diynotaguy/3D-printed-tape-dispenser-with-mechanical-tape-length-measuring/README.md

# 3D-printed-tape-dispenser-with-mechanical-tape-length-measuring
A 3D printed tape dispenser that shows you how long a piece of tape you're pulling out is before you cut it. Works best for washi tape or paper-like tape, because the tape cutter is 3D printed and not very sharp

front on pic
screen Vs irl comparison


# Why I made this
I made the project because I wanted a tape dispenser that would fit in my drawer (its quite a tall/deep drawer) and be usable without taking it out. That's why I designed it so that you pull and cut the tape from above. As for the measuring part, I just thought it might be useful, I'd never seen a tape dispenser measure the tape before, and it seemed challenging and fun to make (which I can confirm is true!!). 

In the future, I'd like to make the measuring more accurate, add a mechanism that automatically resets the measuring cylinder to 0 when the tape is cut, and also make it compatible with gridfinity. 

# You will need
- 3D printer filament (PLA or other rigid filament)
- A 8x22x7mm ball bearing (you might be able to 3D print one from someone else's file)
  
*more details in BOM*

# Printing instructions
The best way is to slice the 'Ship 1 both plates slicer file.3mf' file in Bambu studio, as it should import with the required printing settings. Otherwise, follow the instructions below.

## Orientation
- All parts are oriented correctly in the .3mf file
- If using inividual .step files, automatic orientation works for all pieces - none of them need unusual orientations

## Supports
Only around 3.5g of support is needed, so if you follow these instructions, you should get a similar result:
- turn on tree supports for the bearing casing and tray parts
- turn on normal supports for the bearing holder part

## Brims (in the pictures, the brim is dark blue)
- add brim ears at each corner of the tape cutter part like so 


- add an outer brim to the driven axle/secondary axle part
- add brim ears on either end of the chain like so


- if any other parts are causing warping or adhesion issues, add an outer brim

## Main settings/instructions
- PLA or any other rigid filament can be used
- 0.2mm layer height is suitable
- 2 wall loops, 15% infill is suitable

# Assembly instructions
For simplicity, the assembly instructions are broken up into 6 sections:
1) The chain
2) The driven axle/secondary axle
3) The driving axle/primary axle
4) The tape recovery system
5) Attaching the axles
6) Finishing the tape dispenser

I've arranged the parts on the second build plate in groups so that it's easier to tell which pieces you need to use for which step:



Key:
Purple = driven axle parts
Green = driving axle parts
Red = tape recovery system parts

## 1) The chain
1. Rotate each link in the chain so that it can articulate. You'll probably need pliers to free the two end links, but be careful not to crush them when gripping them with the pliers.
   
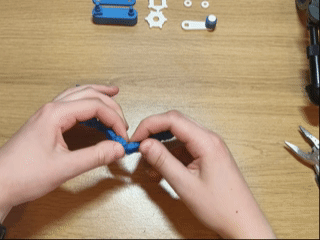
[picture p1: Side project - chain & sprocket mechanism/side project gifs/C&S mech assembly pt1.gif]


2. Rotate the chain into a loop so that the side on the build plate is on the outside. Use a dab of superglue on the dovetail joint where the chain needs join and push the dovetail pin into the socket. I'd recommend using a cocktail stick or something similar to apply the glue to avoid gluing your fingers or jamming the chain.
   
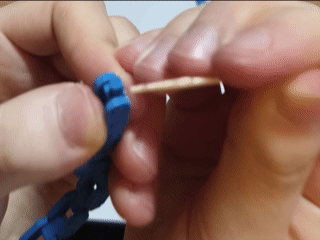
[picture p2: Side project - chain & sprocket mechanism/side project gifs/C&S mech assembly pt2.gif]


## 2) The driven axle
1. Slide the driven gear then the axle spacer on the driven axle. The chamfered end of the axle spacer should be towards the driven gear



2. Slide the number cylinder on the axle, with the numbers going upwards in the clockwise direction when the back of the axle (where the driven gear is) is pointing away from you.


3. Put the axle holder on the axle, with the screw pointing away from the number cylinder


## 3) The driving axle
1. Put the bearing on the bearing holder and screw the bearing holder nut on



2. Push the bearing casing over the bearing


3. Align the square recess in the driving gear with the end of the bearing casing, and screw the driving gear screw through the driving gear and into the bearing casing



4. Your completed driving axle should look like this:


## 4) The tape recovery system
1. Place the push piece in the channel on the tape cutter with the dovetail section poking through the hole


2. Slot the slider onto the end of the push piece dovetail section from the other side of the tape cutter, then slide then push the sider and push piece in opposite directions so they become locked together.



## 5) Attaching the axles
1. Put the chain around the driven gear, then slot the driven axle assembly into the tray on the right hand side. The driven gear & chain need to be at the back, and the screw on the driven axle holder needs to be slotted into the channel on the front right hand side of the tray.



2. Screw the driven axle holder nut onto the screw of the axle holder to secure the driven axle in place


3. Mesh the driving gear on the driving axle assembly with the inside of the chain, then slot the bearing holder into the bearing holder pocket which is on the front left hand side of the tray. The driving axle should also now be secure, and you should be able to rotate the bearing casing or the end of the driven axle to move the chain and therefore move the other axle.



## 6) Finishing it! 
1. Line up the tape cutter (with the tape recovery system attached) with the brackets on the top of the tray, and slide it all the way in 



2. Put your tape roll of choice in the base of the tray with it already partially unrolled. Then push the tape holder part through the middle of your tape roll and into the tray, making sure the tray lines up with the tape holder at both the triangular joint at the back of the tray and the dovetail joint at the front.



3. At the top of the tray, slide your tape tail (the bit you've unrolled already) into its position. It needs to go over the bearing casing, under the tape recovery system, then come out of the tape dispenser by the serrated teeth of the tape cutter. Make sure that the tape tail is either temporarily stuck to a part of the tape cutter or sticking out long enough so that you don't lose it within the tape dispenser when performing the next assembly steps.


4. Line up the reinforcing cross-beam with the top of the whole assembly and push it in. To get it properly past the driven axle holder, you may need to pull the driven axle down while pushing the cross-beam in



5. The tape dispenser should look like this when finished! To make it ready for use, just cut the tape then follow the instructions in the next section
front on pic

# How to use
You can watch [this demo](https://youtube.com/shorts/kDhBerEQ1j0?feature=share) or follow the instructions below
1) Set the number cylinder to 0 by turning the end of the driven axle
2) Slide the slider on top of the tape cutter towards the serrated teeth of the tape cutter and then pick the end of the tape off from the end of the tape recovery push piece
3) Pull the tape. When pulling, you can watch the number on the number cylinder increase through the viewing hole on the top. The little arrow next to the viewing hole points to the current measurement, and the tape is measured in cm.
4) Cut the tape at the desired length by pulling it against the serrated teeth of the tape cutter. For best results, pull **diagonally** towards the back right of the tape dispenser, rather than straight towards the right.
5) If you completed the steps correctly, the cut piece of tape should be similar in length to the measurement given by the tape dispenser. It's not completely accurate though, so give or take a cm.
