diynotaguy/3D-printed-tape-dispenser-with-mechanical-tape-length-measuring/CAD/onshape source file.md

https://cad.onshape.com/documents/6b50cb8246abad94566a4989/w/5acfffb6b951ba959ce26331/e/a58cd0b4d890e8ca2b29ab2b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
