diynotaguy/3D-printed-tape-dispenser-with-mechanical-tape-length-measuring/Pictures/front on pic.jpg

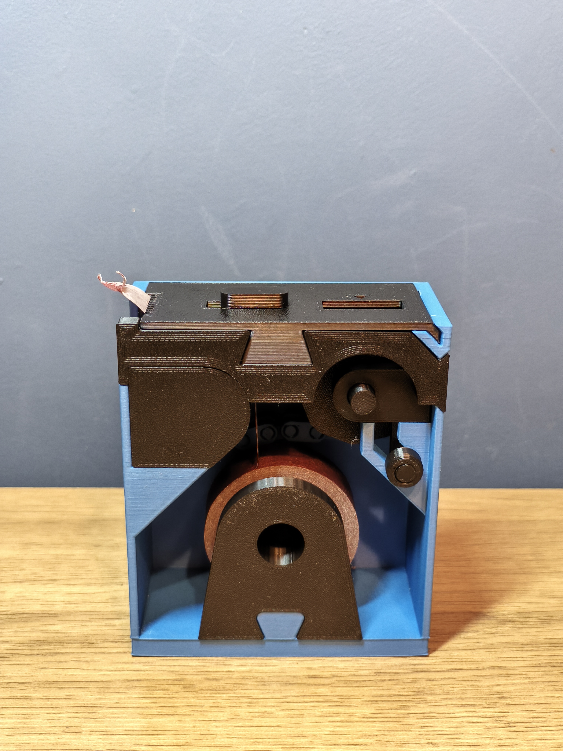
Pictures/front on pic.jpg
