diynotaguy/3D-printed-tape-dispenser-with-mechanical-tape-length-measuring/Side project - chain & sprocket mechanism/side project gifs/Rotating chain landscape gif.gif

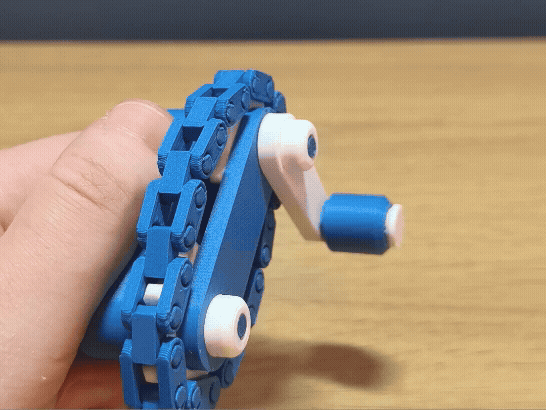
Side project - chain & sprocket mechanism/side project gifs/Rotating chain landscape gif.gif
