diynotaguy/3D-printed-tape-dispenser-with-mechanical-tape-length-measuring/Tape dispenser Ship 1 BOM.csv

Item Name | Qty | Price (total) (USD) | Item link | Notes
102g 3D printer filament (PLA) | 1 | $15.29 | https://us.amazon.com/SUNLU-Printer-Filament-Dimensional-Accuracy/dp/B07ZNHF46J | Based on the price of a 1kg SUNLU PLA spool (which at time of writing is 5% off). The price is for the whole kg but you will only need 102g for the tape dispenser. This is a cheaper alternative to what I used, but you can use any type of standard PLA (or other similar rigid filaments)
22 (OD) * 8 (ID) * 7 mm ball bearing | 1 | $5.99 | https://www.amazon.com/Mlxkell-608-2RS-8mmx-7mmBall-Bearings/dp/B0F2FKKG9K?sp_csd=d2lkZ2V0TmFtZT1zcF9hdGY | Only ONE ball bearing needed - this is the price for the whole pack. This isn't the specific one I used, because I found the one I used just lying around in a hardware box but I measured it and these are the same size.
Shipping for filament & bearings | 1 |  |  | No cost - free delivery from Amazon in the UK
Final notes
Total Price (USD): | $21.28 |  |  | I do not need funding as I've already made it and it is very cheap to make (especially for people who already have filament and some ball bearings lying around)
