diynotaguy/3D-printed-tape-dispenser-with-mechanical-tape-length-measuring/Tape dispenser Ship 1 BOM - Sheet1.csv

Item Name | Qty | Price (total) (USD) | Item link | Notes
102g 3D printer filament (PLA) | 1 | $1.56 | https://us.amazon.com/SUNLU-Printer-Filament-Dimensional-Accuracy/dp/B07ZNHF46J | Based on the price of a 1kg SUNLU PLA spool (which at time of writing is 10% off)
22 (OD) * 8 (ID) * 7 mm ball bearing | 1 | $0.80 | https://www.amazon.com/Mlxkell-608-2RS-8mmx-7mmBall-Bearings/dp/B0F2FKKG9K?sp_csd=d2lkZ2V0TmFtZT1zcF9hdGY | Price of 10 pack ball bearings/10
Shipping for filament & bearings | 1 |  |  | No cost - free delivery from Amazon in the UK
Total Price (USD): | $2.36
