diynotaguy/3D-printed-tape-dispenser-with-mechanical-tape-length-measuring/CAD/Ship 1 assembly.step

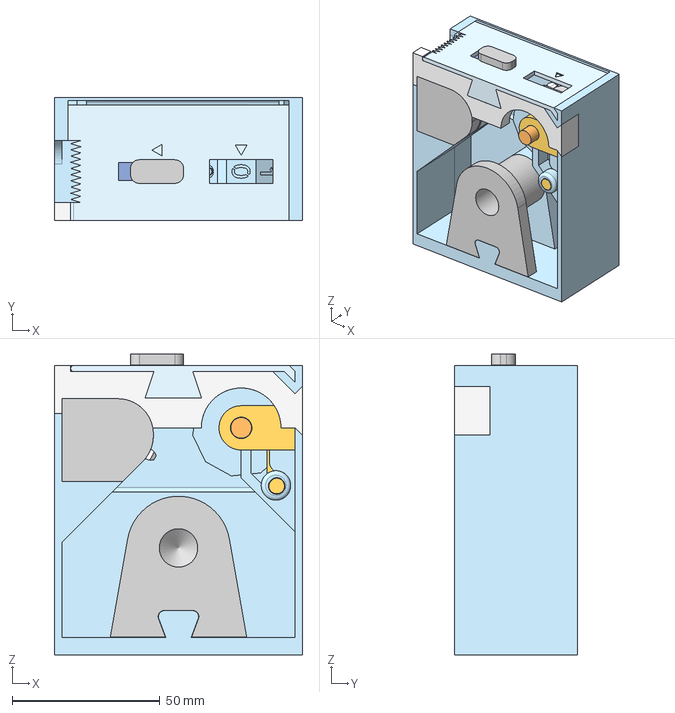
[picture p7: CAD file, 2026-11-01]
CAD/Ship 1 assembly.step
84.0 x 41.5 x 101.9 mm
