diynotaguy/3D-printed-tape-dispenser-with-mechanical-tape-length-measuring/CAD/Individual step files/Tape dispenser - Bearing casing.step

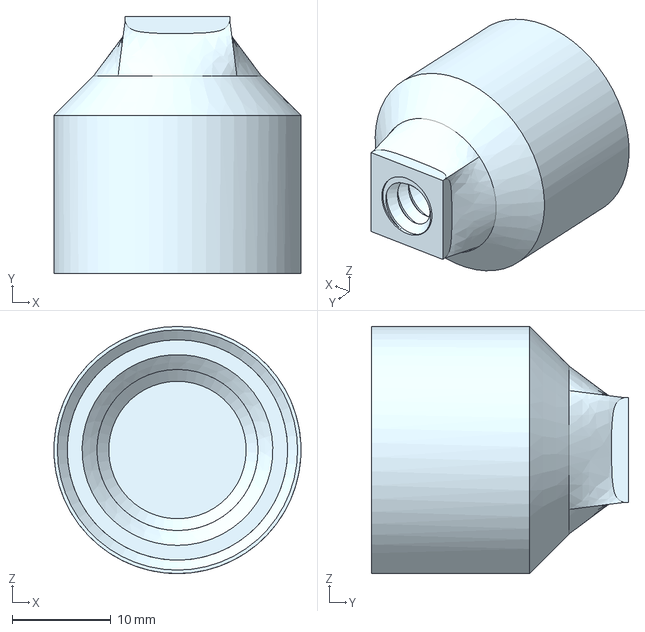
[picture p8: CAD file, 2026-11-01]
CAD/Individual step files/Tape dispenser - Bearing casing.step
25.0 x 26.0 x 25.0 mm
