diynotaguy/3D-printed-tape-dispenser-with-mechanical-tape-length-measuring/CAD/Ship 1 slicer file.3mf

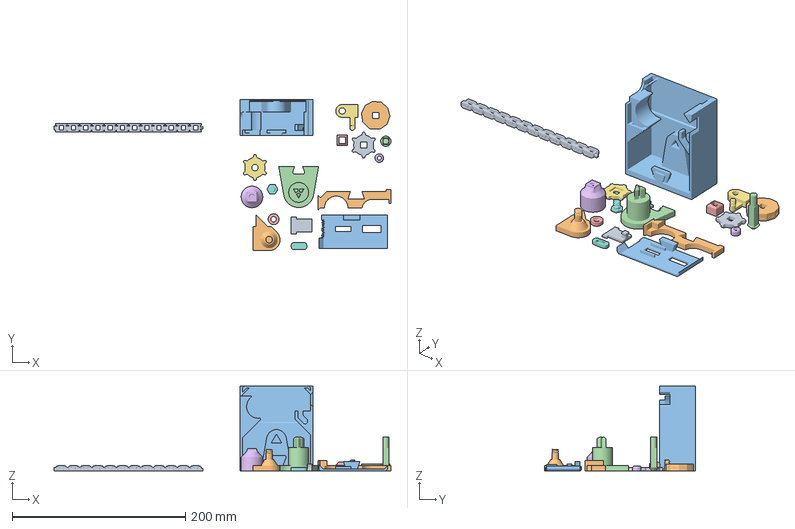
[picture p9: CAD file, 2026-11-01]
CAD/Ship 1 slicer file.3mf
389.1 x 174.4 x 98.0 mm
Test rig optimized chain V1.stl
Bearing holder
Tray
Tape holder
Bearing holder nut
Bearing casing
Driving gear
Driving gear screw
Driven gear
Number cylinder
Tape cutter
Driven axle
Driven axle spacer
Driven axle holder nut
Driven axle holder
Tape recovery slider
Tape recovery push piece
Reinforcing cross-beam
