diynotaguy/3D-printed-tape-dispenser-with-mechanical-tape-length-measuring/Side project - chain & sprocket mechanism/Chain & sprocket test rig slicer file.3mf

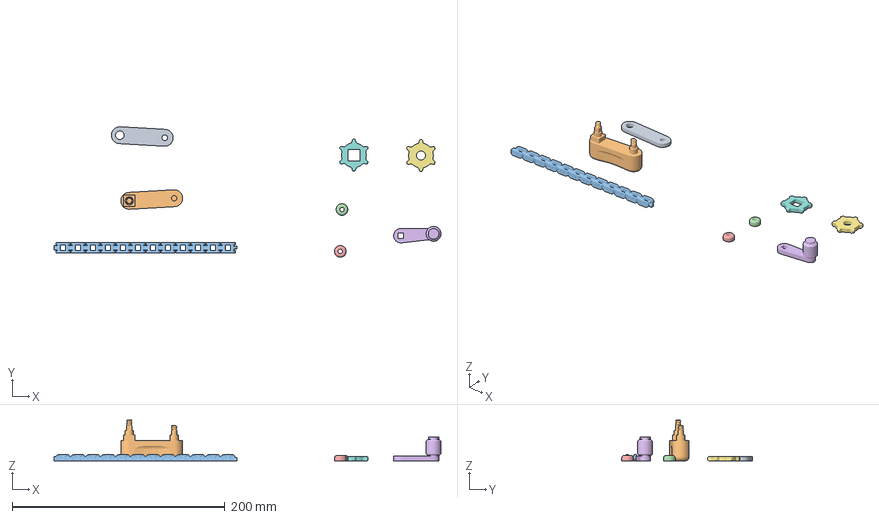
[picture p10: CAD file, 2026-11-01]
Side project - chain & sprocket mechanism/Chain & sprocket test rig slicer file.3mf
363.8 x 122.7 x 38.4 mm
Chain test rig top T2.stl
Chain test rig base T2.stl
Test rig optimized chain V1.stl
Chain test rig nut T2.stl x 2
Test rig handle T2 V2.stl
Test rig driven gear T2 V4.stl
Test rig driving gear T2 V4.stl
