diynotaguy/3D-printed-tape-dispenser-with-mechanical-tape-length-measuring/Side project - chain & sprocket mechanism/Side project individual step files/Base.step

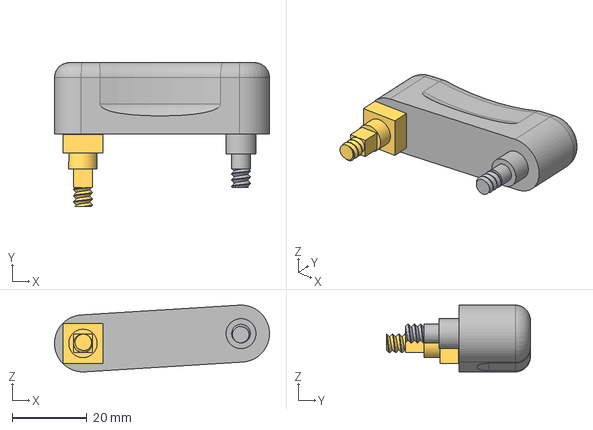
[picture p11: CAD file, 2026-11-01]
Side project - chain & sprocket mechanism/Side project individual step files/Base.step
57.4 x 38.4 x 17.8 mm
