diynotaguy/3D-printed-tape-dispenser-with-mechanical-tape-length-measuring/CAD/Individual step files/Tape dispenser - Reinforcing cross-beam.step

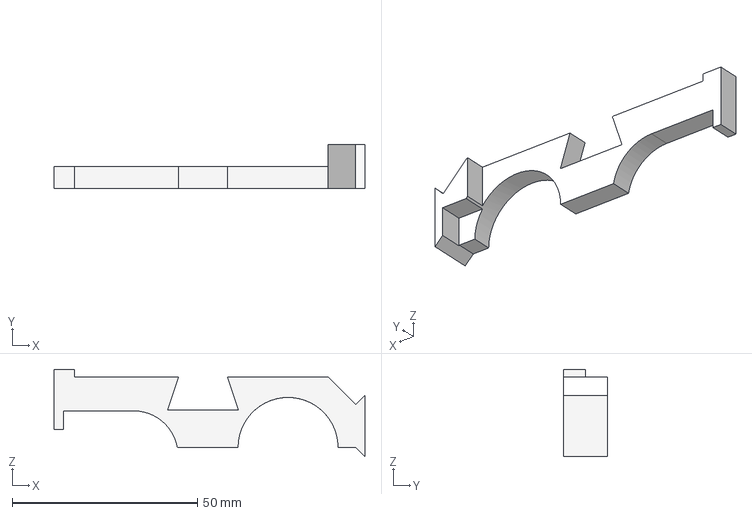
[picture p12: CAD file, 2026-11-01]
CAD/Individual step files/Tape dispenser - Reinforcing cross-beam.step
84.0 x 12.0 x 23.6 mm
