diynotaguy/3D-printed-tape-dispenser-with-mechanical-tape-length-measuring/Side project - chain & sprocket mechanism/Side project individual step files/Chain.step

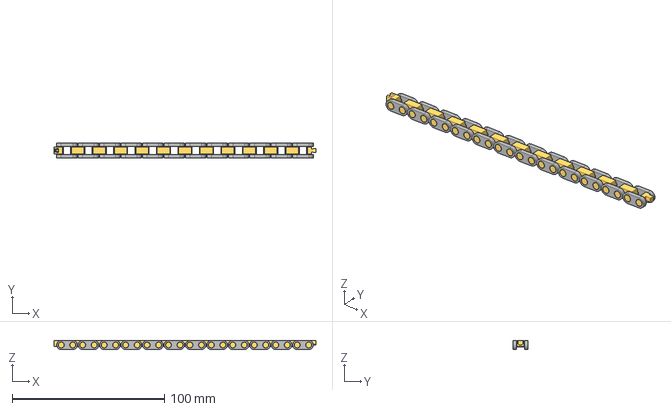
[picture p14: CAD file, 2026-11-01]
Side project - chain & sprocket mechanism/Side project individual step files/Chain.step
172.2 x 9.60 x 6.00 mm
