diynotaguy/3D-printed-tape-dispenser-with-mechanical-tape-length-measuring/CAD/Individual step files/Tape dispenser - Tape recovery push piece.step

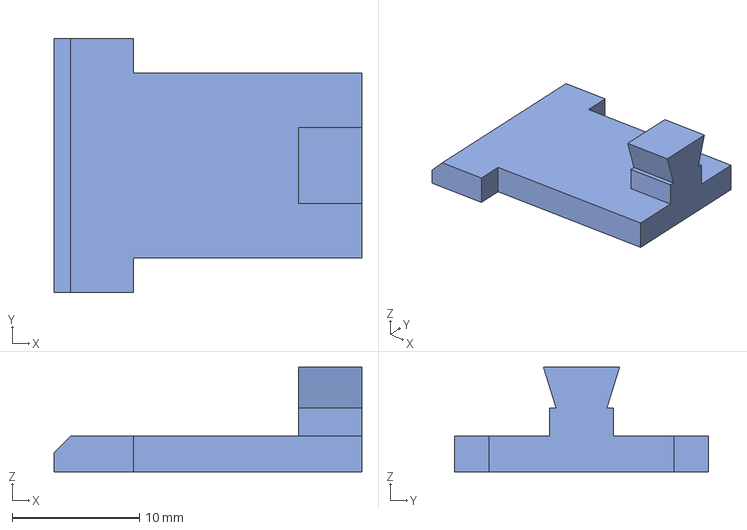
[picture p15: CAD file, 2026-11-01]
CAD/Individual step files/Tape dispenser - Tape recovery push piece.step
24.2 x 20.0 x 8.23 mm
