diynotaguy/3D-printed-tape-dispenser-with-mechanical-tape-length-measuring/Side project - chain & sprocket mechanism/Side project individual step files/Driving gear.step

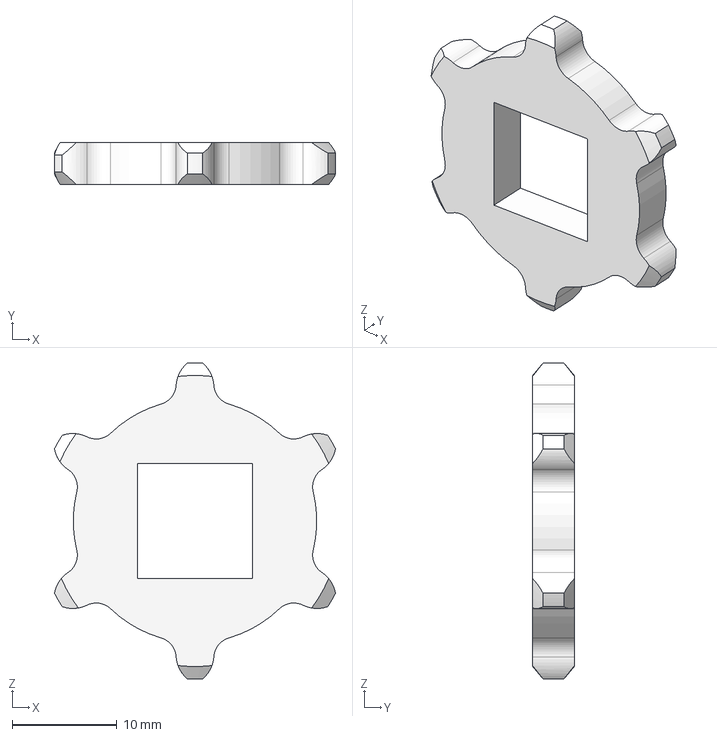
[picture p16: CAD file, 2026-11-01]
Side project - chain & sprocket mechanism/Side project individual step files/Driving gear.step
26.8 x 4.00 x 30.2 mm
