diynotaguy/3D-printed-tape-dispenser-with-mechanical-tape-length-measuring/CAD/Individual step files/Tape dispenser - Tape recovery slider.step

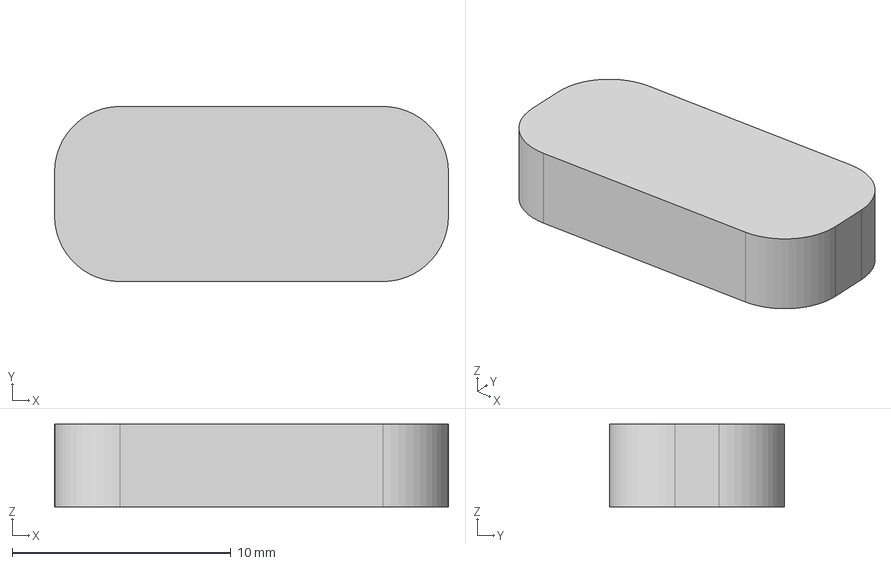
[picture p17: CAD file, 2026-11-01]
CAD/Individual step files/Tape dispenser - Tape recovery slider.step
18.0 x 8.00 x 3.78 mm
