diynotaguy/3D-printed-tape-dispenser-with-mechanical-tape-length-measuring/Side project - chain & sprocket mechanism/Side project individual step files/Top.step

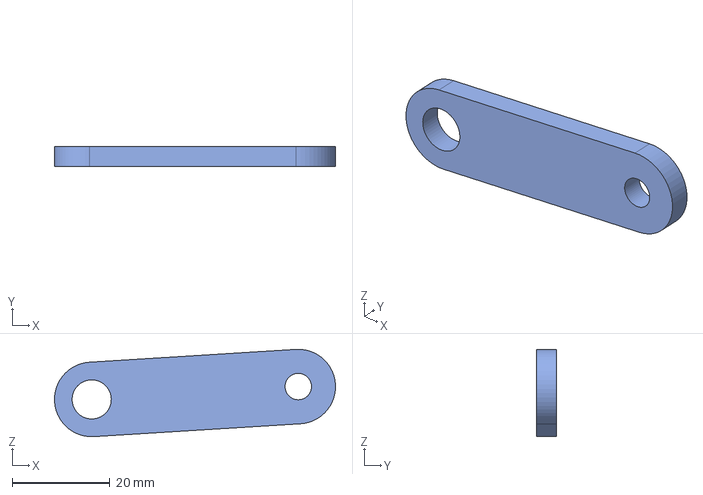
[picture p18: CAD file, 2026-11-01]
Side project - chain & sprocket mechanism/Side project individual step files/Top.step
57.4 x 4.00 x 17.8 mm
