diynotaguy/3D-printed-tape-dispenser-with-mechanical-tape-length-measuring/CAD/Individual step files/Tape dispenser - Driven axle spacer.step

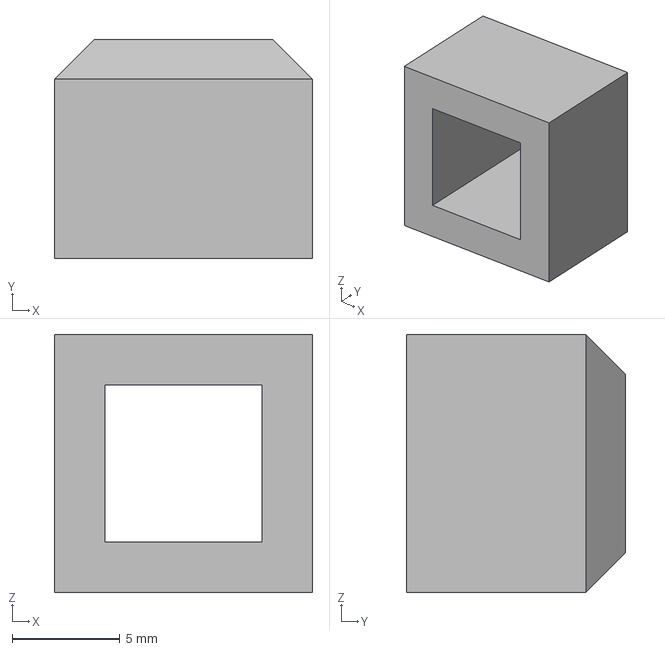
[picture p19: CAD file, 2026-11-01]
CAD/Individual step files/Tape dispenser - Driven axle spacer.step
12.0 x 10.2 x 12.0 mm
