diynotaguy/3D-printed-tape-dispenser-with-mechanical-tape-length-measuring/Side project - chain & sprocket mechanism/Side project individual step files/Handle.step

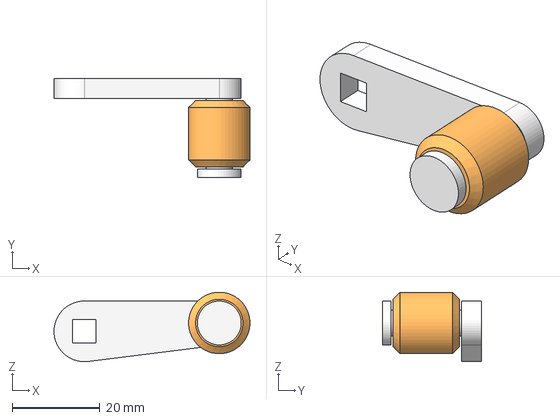
[picture p20: CAD file, 2026-11-01]
Side project - chain & sprocket mechanism/Side project individual step files/Handle.step
44.6 x 22.6 x 15.8 mm
