diynotaguy/3D-printed-tape-dispenser-with-mechanical-tape-length-measuring/CAD/Individual step files/Tape dispenser - Tape holder.step

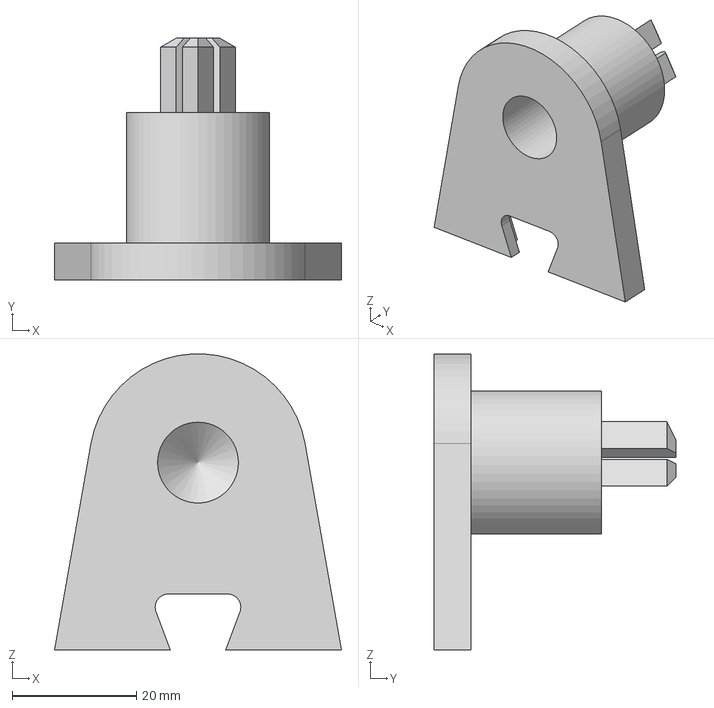
[picture p21: CAD file, 2026-11-01]
CAD/Individual step files/Tape dispenser - Tape holder.step
46.2 x 39.0 x 47.6 mm
