diynotaguy/3D-printed-tape-dispenser-with-mechanical-tape-length-measuring/CAD/Individual step files/Tape dispenser - Bearing holder.step

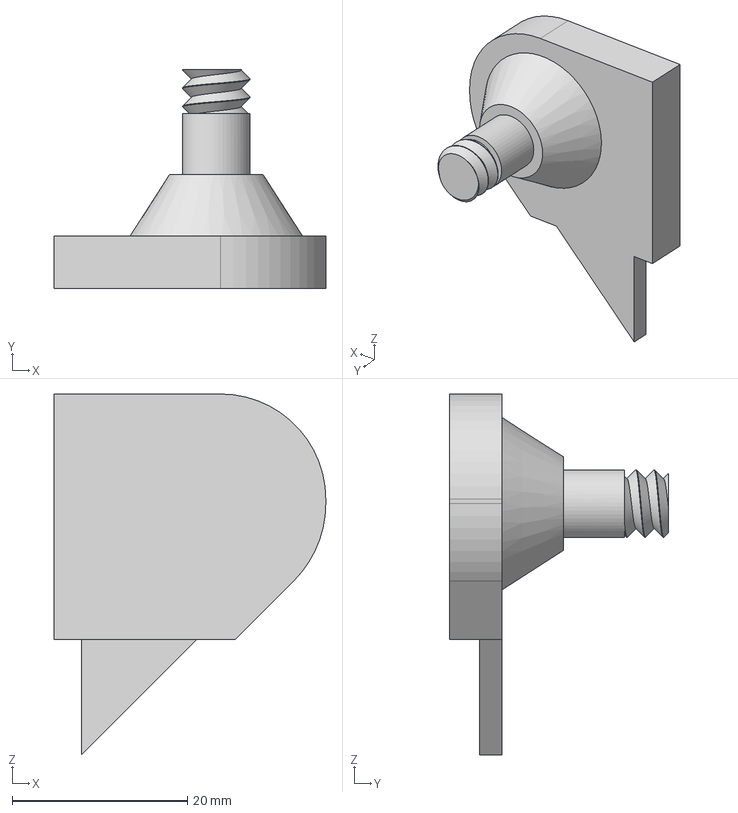
[picture p22: CAD file, 2026-11-01]
CAD/Individual step files/Tape dispenser - Bearing holder.step
31.0 x 25.0 x 41.2 mm
