diynotaguy/3D-printed-tape-dispenser-with-mechanical-tape-length-measuring/CAD/Individual step files/Tape dispenser - Number cylinder.step

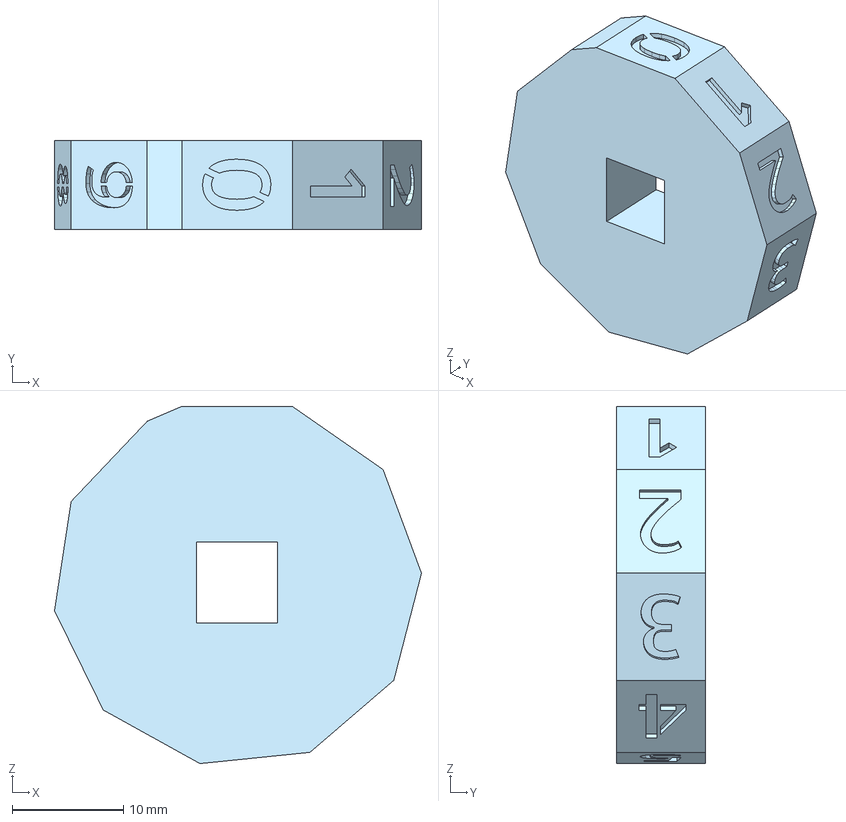
[picture p23: CAD file, 2026-11-01]
CAD/Individual step files/Tape dispenser - Number cylinder.step
33.0 x 8.00 x 32.1 mm
