diynotaguy/3D-printed-tape-dispenser-with-mechanical-tape-length-measuring/CAD/Individual step files/Tape dispenser - Driven axle.step

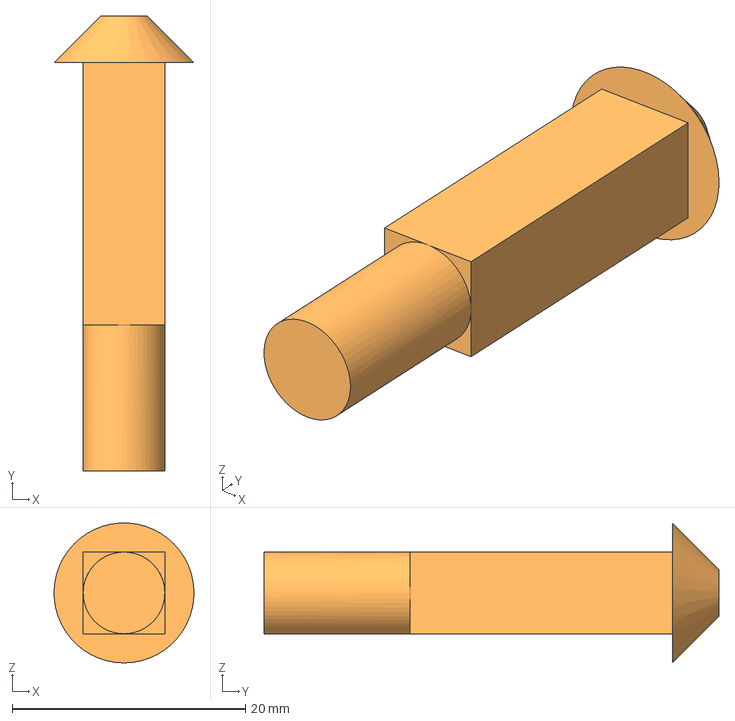
[picture p24: CAD file, 2026-11-01]
CAD/Individual step files/Tape dispenser - Driven axle.step
12.0 x 39.0 x 12.0 mm
