diynotaguy/3D-printed-tape-dispenser-with-mechanical-tape-length-measuring/CAD/Individual step files/Tape dispenser - Tray.step

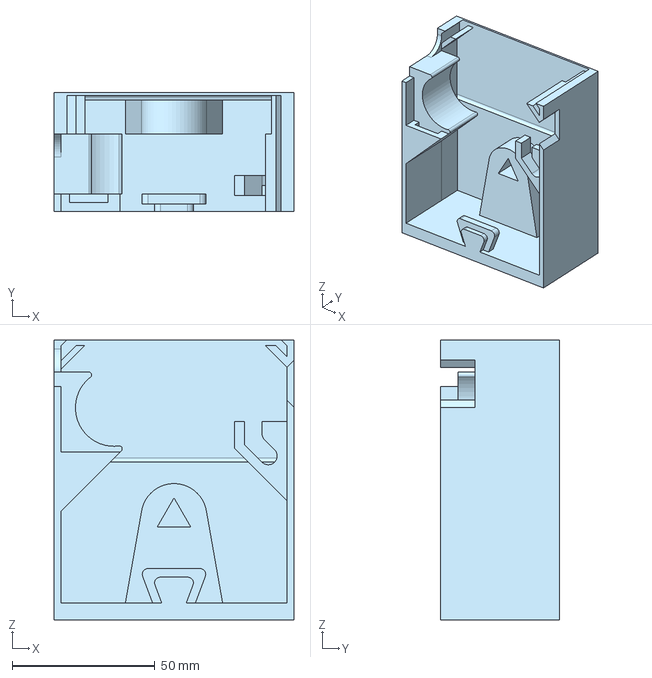
[picture p25: CAD file, 2026-11-01]
CAD/Individual step files/Tape dispenser - Tray.step
84.0 x 41.5 x 98.0 mm
