diynotaguy/3D-printed-tape-dispenser-with-mechanical-tape-length-measuring/CAD/Individual step files/Tape dispenser - Tape cutter.step

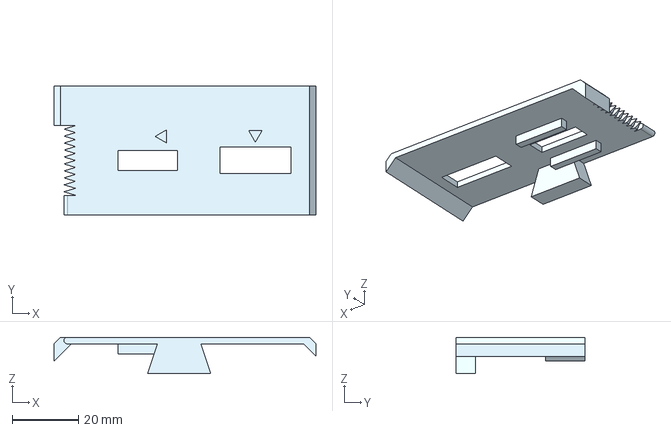
[picture p26: CAD file, 2026-11-01]
CAD/Individual step files/Tape dispenser - Tape cutter.step
79.0 x 39.0 x 11.0 mm
