diynotaguy/3D-printed-tape-dispenser-with-mechanical-tape-length-measuring/CAD/Individual step files/Tape dispenser - Driven axle holder.step

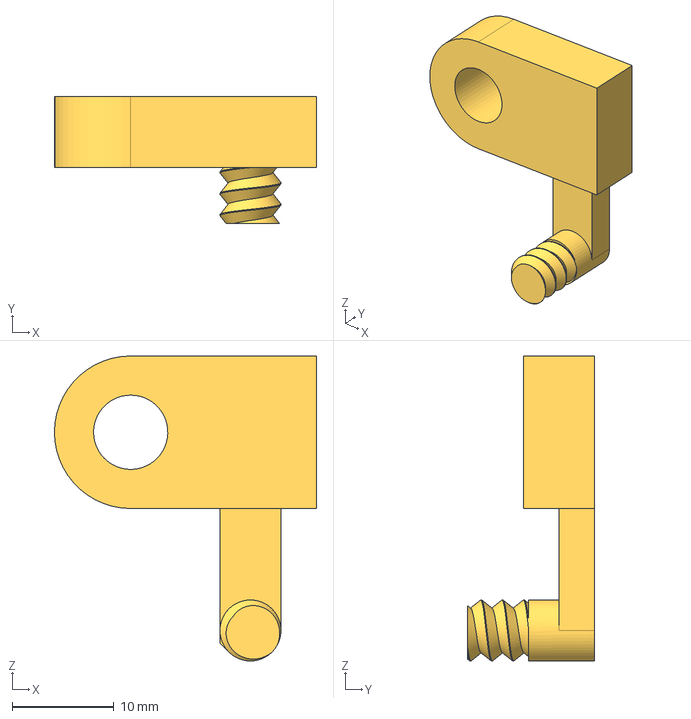
[picture p27: CAD file, 2026-11-01]
CAD/Individual step files/Tape dispenser - Driven axle holder.step
25.8 x 12.5 x 30.0 mm
