diynotaguy/3D-printed-tape-dispenser-with-mechanical-tape-length-measuring/(list of files, cad)

Other CAD files:
CAD/Orentation 3mf without slicer settings.3mf
CAD/Individual step files/Tape dispenser - Driven gear.step
CAD/Individual step files/Tape dispenser - Driving gear.step
CAD/Individual step files/Tape dispenser - Bearing holder nut.step
CAD/Individual step files/Tape dispenser - Driven axle holder nut.step
CAD/Individual step files/Tape dispenser - Driving gear screw.step
Side project - chain & sprocket mechanism/Side project individual step files/Nut (x2).step
