diynotaguy/3D-printed-tape-dispenser-with-mechanical-tape-length-measuring/Pictures/CAD assembly screenshot.png

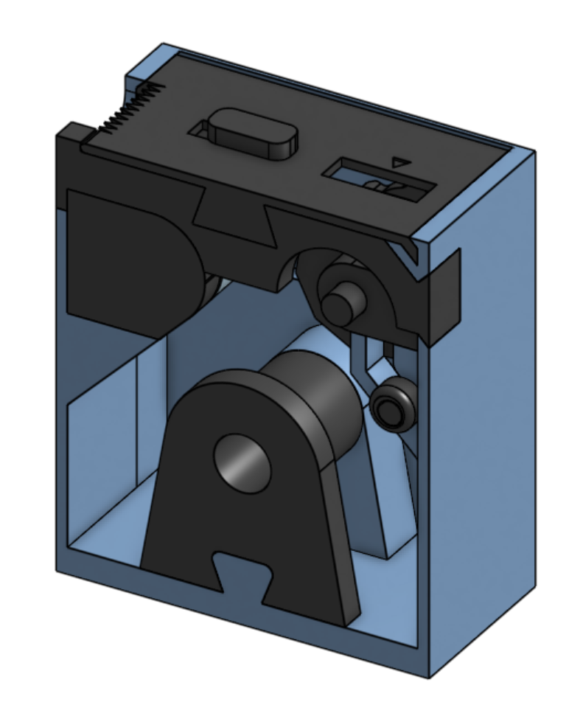
Pictures/CAD assembly screenshot.png
