diynotaguy/3D-printed-tape-dispenser-with-mechanical-tape-length-measuring/(commit log)

2026-11-01 Rename Tape dispenser Ship 1 BOM - Sheet1.csv to Tape dispenser Ship 1 BOM.csv
    [Tape dispenser Ship 1 BOM.csv]
2026-11-01 Rename Ship 1 both plates slicer file.3mf to Orentation 3mf without slicer settings.3mf
    [Orentation 3mf without slicer settings.3mf]
2026-11-01 Rename CAD/(OPTIONAL) Chain and sprocket demo/Side project README.md to Side project - chain & sprocket mechanism/Side project README.md
2026-11-01 Rename CAD/(OPTIONAL) Chain and sprocket demo/Chain & sprocket test rig slicer file.3mf to Side project - chain & sprocket mechanism/Chain & sprocket test rig slicer file.3mf
    [Chain & sprocket test rig slicer file.3mf]
2026-11-04 Added updated BOM
    With prices for the whole of each thing being bought rather than just the portion thats needed. Added some clarifying notes as well
    [Tape dispenser Ship 1 BOM - updated.csv]
2026-11-04 Rename Tape dispenser Ship 1 BOM - updated.csv to Tape dispenser Ship 1 BOM.csv
    [Tape dispenser Ship 1 BOM.csv]
